tausif-sama/Bangladesh_Team-Prodigy/chassis/readme.md

Chassis 
====

The chassis base plate is made of Aluminum and the rest of the parts involve brass spacers, acrylic top plates, front articulating axel parts and some other miscellaneous parts.

## Parts:

+ Main Chassis: https://yfrobot.com/collections/robot-kits/products/steering-gear-robot
+ Camera Mount (3D Printed): https://www.thingiverse.com/thing:3114849
+ Sonar Sensor Mount: (3D Printed): https//www.thingiverse.com/thing:4104129
