tausif-sama/Bangladesh_Team-Prodigy/robot_photos/back.jpg

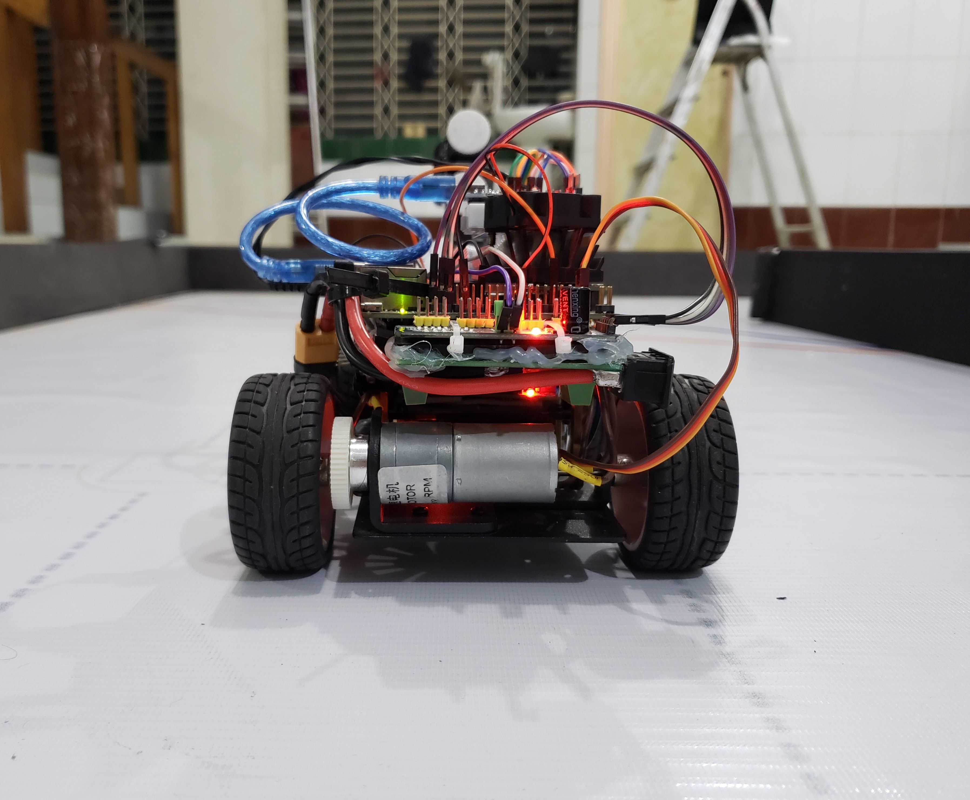
robot_photos/back.jpg
