tausif-sama/Bangladesh_Team-Prodigy/robot_photos/bottom.jpg

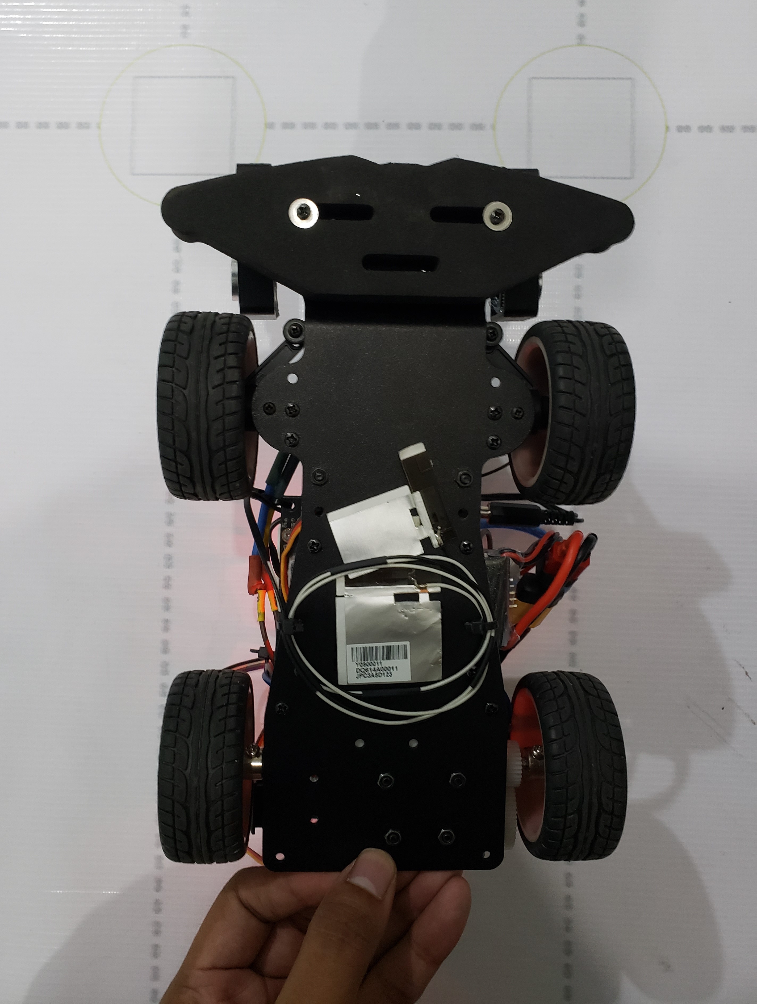
robot_photos/bottom.jpg
