tausif-sama/Bangladesh_Team-Prodigy/robot_photos/front.jpg

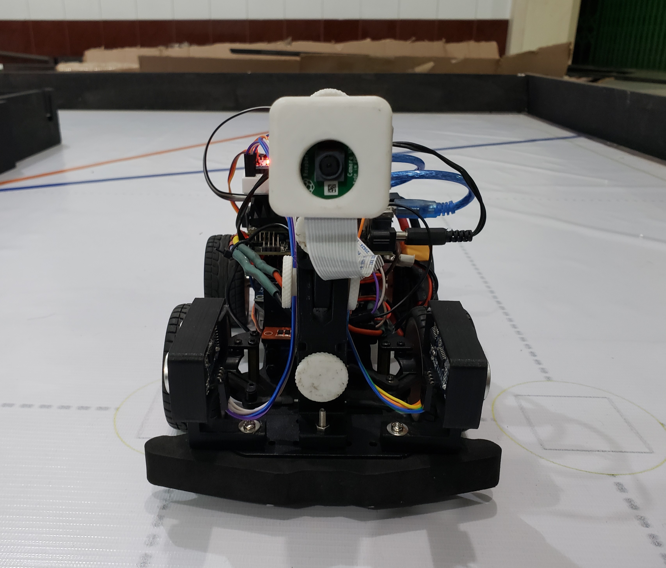
robot_photos/front.jpg
