tausif-sama/Bangladesh_Team-Prodigy/robot_photos/left.jpg

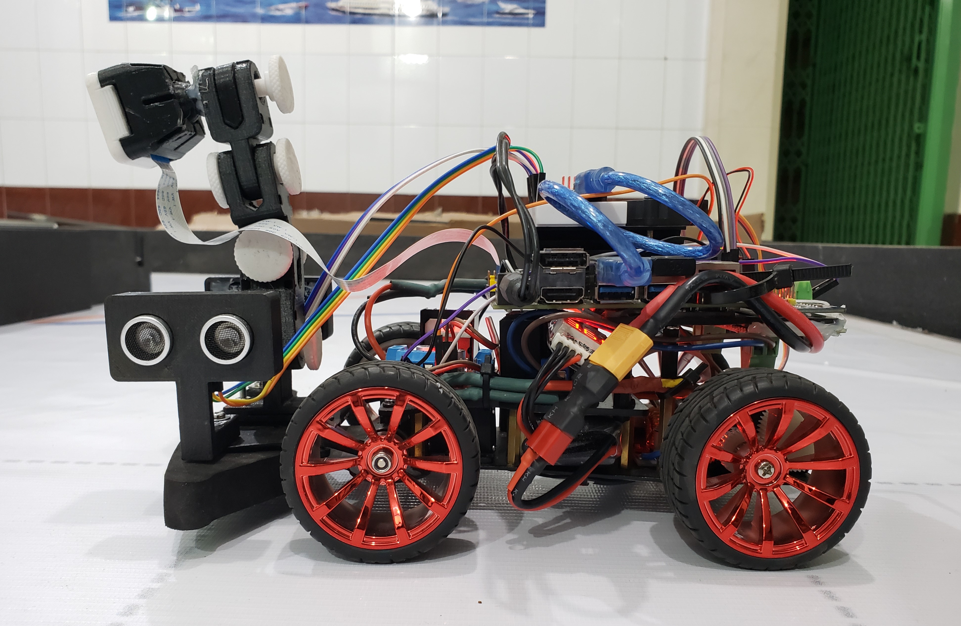
robot_photos/left.jpg
