tausif-sama/Bangladesh_Team-Prodigy/robot_photos/right.jpg

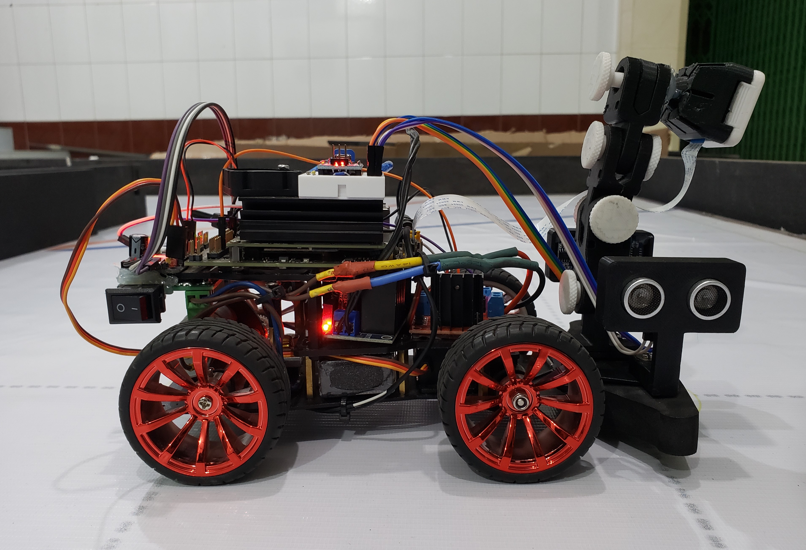
robot_photos/right.jpg
