tausif-sama/Bangladesh_Team-Prodigy/robot_photos/top.jpg

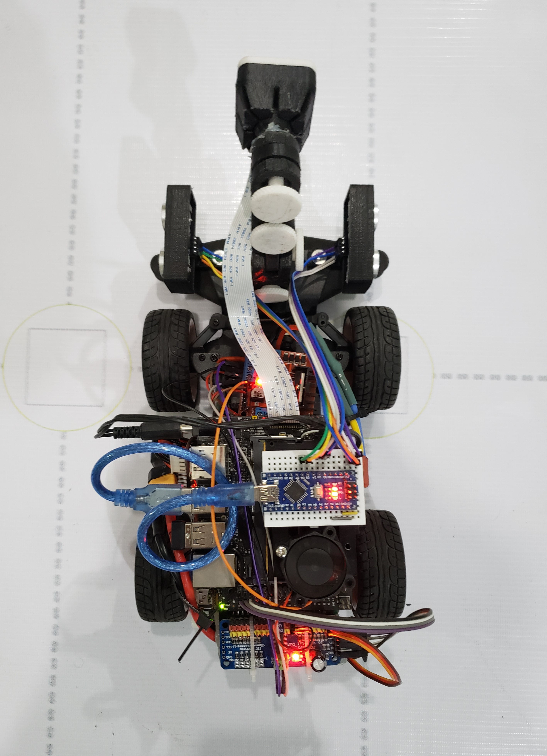
robot_photos/top.jpg
