tausif-sama/Bangladesh_Team-Prodigy/schematics/Schematic_Badur Gaddi v0.1.5.png

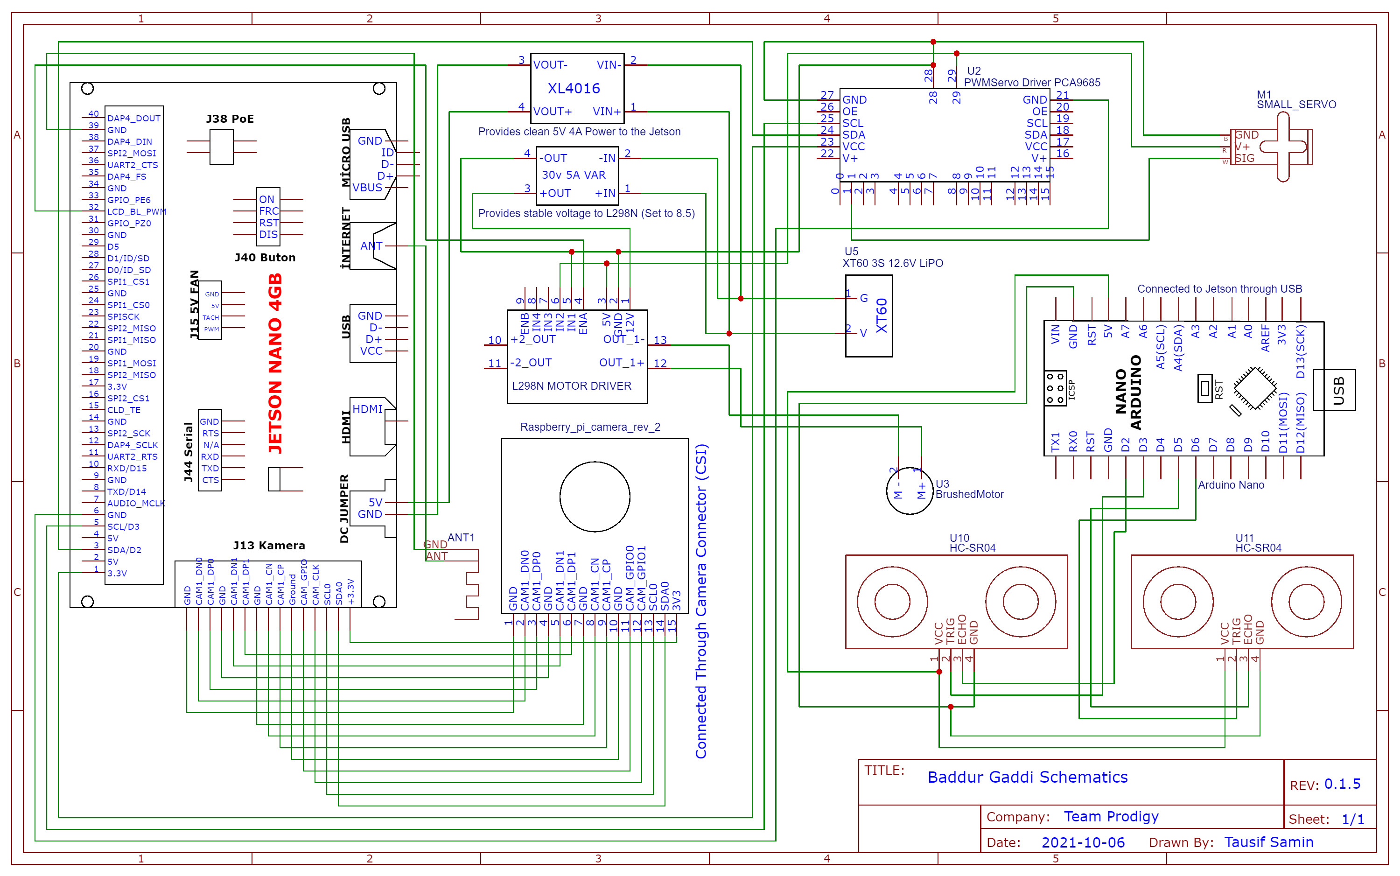
schematics/Schematic_Badur Gaddi v0.1.5.png
