tausif-sama/Bangladesh_Team-Prodigy/team_photos/funny_photo.jpg

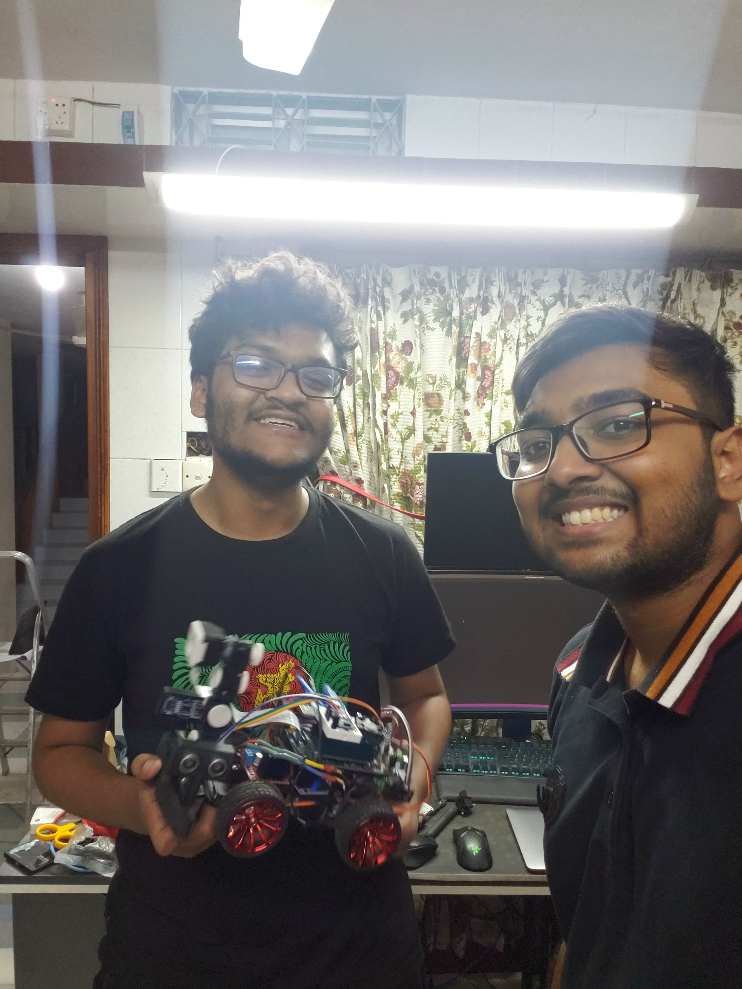
team_photos/funny_photo.jpg
