tausif-sama/Bangladesh_Team-Prodigy/team_photos/Team Photo.jpg

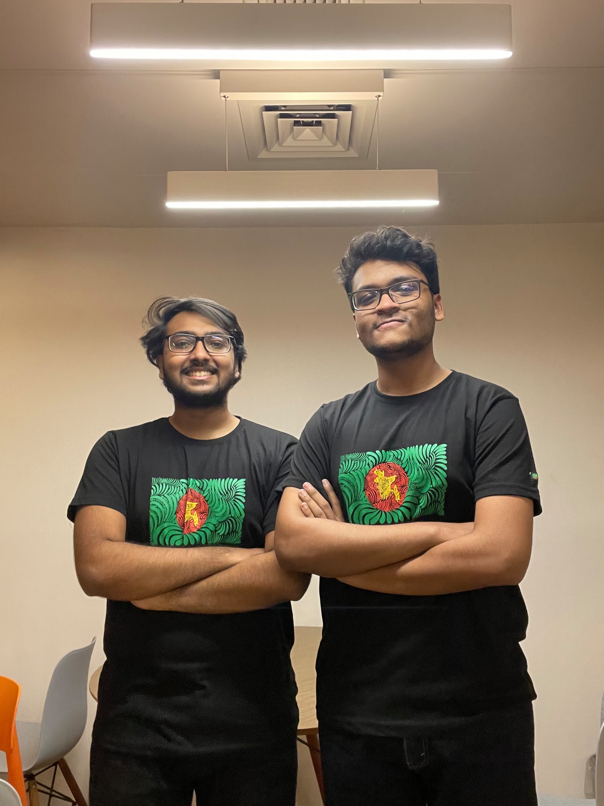
team_photos/Team Photo.jpg
