tausif-sama/Bangladesh_Team-Prodigy/schematics/Schematic_Badur Gaddi v0.1.5.pdf

A

A

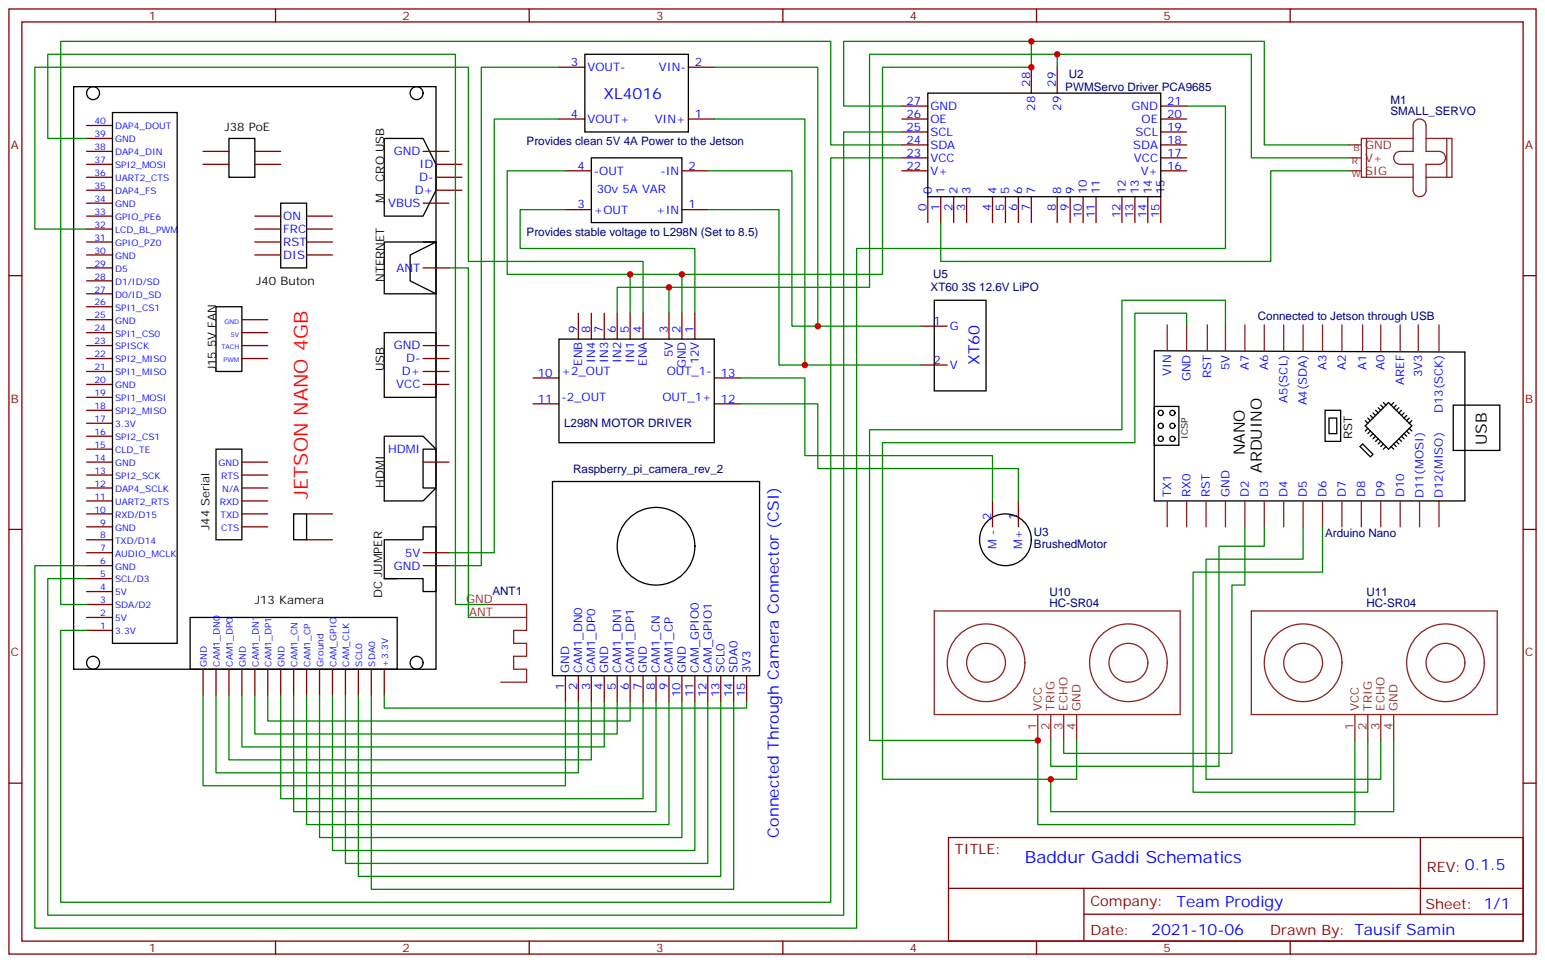
[picture p21: page 1]

V+ 22 VCC 23 SDA 24 SCL 25 OE 26 GND 27

V+ 16 VCC 17 SDA 18 SCL 19 OE 20 GND 21

Provides clean 5V 4A Power to the Jetson

Provides stable voltage to L298N (Set to 8.5)

Connected to Jetson through USB

Connected Through Camera Connector (CSI)

Drawn By: Tausif Samin
