tausif-sama/Bangladesh_Team-Prodigy/(list of files, drawings)

Other design files:
schematics/SCH_Badur Gaddi v0.1.5.json
