tausif-sama/Bangladesh_Team-Prodigy/(commit log)

2021-11-11 added schematics
2021-11-19 updated schematics
    [SCH_Badur Gaddi v0.1.5.json]
2021-11-19 schematic instructions
2021-11-19 updated schematics instructions
2021-11-19 updated chassis
2021-11-19 updated chassis details
